thorpej/sot8/design-files/control-unit/control-unit.kicad_pcb

## KiCad design IRSensor.sch


Parts:
C2: 0.01u
C3: 47u
D1: IR26-21C_L110_TR8; LED_1206_3216Metric
D2: LED
IC1: LM555
Q2: 2N3904; TO-92_Inline
Q3: 2N3906; TO-92_Inline
R5, R8: 10k
R6: 1k
R7: 220E
R9: 220
U1: TSOP1738; Vishay_CAST-3Pin
V2: dc 5
V3, V4: 5V
Vin1: dc 0 ac 1 sin(0,1,10k,0,0)
Vt1: dc 0

Connections:
0: Q3.1 (E), U1.1 (GND), V3.2 (E2), V4.2 (E2), Vt1.1 (E1)
GND: C2.2, C3.2, IC1.1 (GND), Q2.1 (E), V2.2 (E2), Vin1.2 (E2)
IROut: D2.1 (K), Q3.3 (C), Vt1.2 (E2)
IpFromIC1: IC1.2 (TR), Vin1.1 (E1)
unnamed: C2.1, IC1.5 (CV)
unnamed: C3.1, IC1.6 (THR), IC1.7 (DIS), R5.2
unnamed: D1.1 (K), Q2.3 (C), R7.2
unnamed: D1.2 (A), IC1.4 (R), IC1.8 (VCC), R5.1, R7.1, V2.1 (E1)
unnamed: D2.2 (A), R9.2
unnamed: IC1.3 (Q), R6.2
unnamed: Q2.2 (B), R6.1
unnamed: Q3.2 (B), R8.1
unnamed: R8.2, U1.3 (OUT)
unnamed: R9.1, V4.1 (E1)
unnamed: U1.2 (Vs), V3.1 (E1)

Notes on the sheet:
.tran 0.01ms 0.1s .control run gnuplot IRSensor.plt V(Vin1),V(Vt1) .endc
