thorpej/sot8/design-files/control-unit/control-unit.kicad_pcb

## KiCad design Input.sch


Parts:
C1: 47u
Q1: 2N3906; TO-92_Inline
R1: 1k
R2, R3, R4: 10k
SW1: SW_Reed_Opener
V1: dc 5

Connections:
GND: C1.2, R2.2, R4.2, V1.2 (E2)
HallSensorOut: Q1.1 (E), R3.2
unnamed: C1.1, Q1.3 (C), R4.1
unnamed: Q1.2 (B), R2.1, SW1.2
unnamed: R1.1, R3.1, V1.1 (E1)
unnamed: R1.2, SW1.1
