thorpej/sot8/(commit log)

2021-12-12 Initial version of microcode generator and assembler.
2021-12-13 Add an example program that multiplies a couple of numbers. (This was primarily used to test the assembler.)
2021-12-14 First pass at the clock module.
    [clock-module.kicad_pcb, clock-module.sch]
2021-12-16 First pass at the register module.
    [register-module.kicad_pcb, register-module.sch]
2021-12-16 Don't put the global control signals in bold.
    [clock-module.sch]
2021-12-16 Update the clock module with the DC jack the boards will use.
    [clock-module.sch]
2021-12-17 Add footprints to the pots and switches on the clock module.
    [clock-module.sch]
2021-12-17 Add footprints to the 'lytics on the clock module.
    [clock-module.sch]
2021-12-17 First pass at the ALU module.
    [alu-module.kicad_pcb, alu-module.sch]
2021-12-18 First pass at the special register module (PC, IV, SP).
    [special-register-module.kicad_pcb, special-register-module.sch]
2021-12-19 First pass at control unit.
    [control-unit.kicad_pcb, control-unit.sch]
2021-12-19 clock-module: 1- Remove ~CLK signal. there is no need to make that an output from the clock module; only the control unit uses it. 2- Document the nominal frequency range for the auto clock.
    [clock-module.sch]
2021-12-19 clock module: - Don't show the value for each part of a multi-unit device. - Use a green LED for the clock visual.
    [clock-module.sch]
2021-12-20 register-module: Document the nominal frequency of the display mux clock.
    [register-module.sch]
2021-12-22 README.md: Fix a couple of typos.
2021-12-22 clock-module: switch to a Nichicon electrolytic with a smaller footprint.
    [clock-module.sch]
2021-12-22 clock-module: ...and the other 1uF electrolytic, too.
    [clock-module.sch]
2021-12-22 control-unit: Add a .1 second RC delay on the reset button so that _RST is asserted momentarily at power-up.
    [control-unit.sch]
2021-12-22 control-unit: Discharge the capacitor on the reset signal through a 1K resistor.
    [control-unit.sch]
2021-12-23 Connect the insn latch, CC latch, and CC register to _RST.
    [control-unit.sch]
2022-01-12 For ALU_B, don't use an AND gate with CLK to do the write-enable, as this could cause spurious rising-edges, and thus spurious loads into the register. Use a pair of '157 muxes in front of the regist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
    [alu-module.sch, control-unit.sch]
2022-01-16 Rework to use DIP resistor packs for the LEDs.
    [register-module.sch]
2022-01-16 Annotate for resistor packs.
    [register-module.sch]
2022-01-16 Rework to use DIP register packs for the LEDs.
    [control-unit.sch]
2022-01-16 Use a yellow / amber LED for the clock pulse.
    [clock-module.sch]
2022-01-16 Change to 5mm LS ceramic caps.
    [clock-module.sch]
2022-01-16 Make the IV register a '377; there isn't really any reason to make it reset to 0 at the beginning of each instruction.
    While here, fix the CC selector; Enable is active-low.
    [control-unit.sch, special-register-module.sch]
2022-01-16 Oops, fix the _IVW indicator LED; it's an active-low signal now.
    [control-unit.sch]
2022-01-25 Duh, tie the carry input of the lower PC 4-bits to GND.
    [special-register-module.sch]
2022-01-25 Use a pair of 74HCT161s as the ALU B register. By just never having them count, we get all the behavior we want (gated clock for loading value + async reset).
    [alu-module.sch]
2022-01-25 Revert "Duh, tie the carry input of the lower PC 4-bits to GND."
    (Because my brain wasn't working yet this morning and that isn't
    the carry input, duh.)
    This reverts commit e98bb7ee4fd320384a5fe867bea251212fd383d8.
    [special-register-module.sch]
2022-01-25 Put the special register module on a larger schematic sheet in preparation for other changes.
    [special-register-module.sch]
2022-01-25 Use a pair of 74HCT161s for the stack pointer register; we want the SP to reset to 0 with the ~RST signal. This saves havint to burn an instruction to initialize the SP at the start of every program.
    [special-register-module.sch]
2022-01-25 Neaten up and re-annotate all of the components in the special register module.
    [special-register-module.sch]
2022-01-25 Re-annotate ICs on the ALU module.
    [alu-module.sch]
2022-01-25 Re-annotate the LEDs on the ALU module.
    [alu-module.sch]
2022-01-25 Tidy up the connection of the N flag in the ALU module.
    [alu-module.sch]
2022-01-27 assembler: Add a -t option to output a text file with visual representation of how to set the programming switches to enter the program.
